camzmac/internet-alarm-clock/BOM.xlsx

Project | Alarm Clock | Number of boards: | 1
Revision | A1
Date | 2017-02-08
By | Cameron MacGregor
ID | SCHEMATIC REFS | DESCRIPTION | MFG | MFG PART # | Digi-Key PART # | UNIT PRICE [CAD] | QUANTITY PER BOARD | ORDER QUANTITY | SUBTOTAL | COMMENT
 | n/a | LAUNCHPAD DEV BRD FOR MSP430G2XX | Texas Instruments | MSP-EXP430G2 | 296-27570-ND | 15.21 | 0 | 0 | 0 | Backup MCU platform
 | n/a | LED 7-SEG .4" 4DGT COMMON CATHODE | Lite-On Inc. | LTC-4727JR | 160-1551-5-ND | 5.81 | 0 | 0 | 0 | Replaced with HDSP-B03E
 | U1 | IC DVR LED 64LED/7SEG I2C 24QSOP | ams | AS1115-BSST | AS1115-BSSTCT-ND | 6.31 | 1 | 2 | 12.62
 | DS2 | LCD DISPLAY RGB LED BKLT 20 X 2 | Newhaven Display Intl | NHD-C0220BIZ-FS(RGB)-FBW-3VM | NHD-C0220BIZ-FS(RGB)-FBW-3VM-ND | 17.6 | 1 | 1 | 17.6
 | n/a | CONN HEADER VERT 6POS .100 TIN | TE Connectivity AMP Connectors | 640456-6 | A1923-ND | 0.4 | 0 | 0 | 0 | Replaced with 61200621621
 | n/a | CONN RECEPT 6POS 24AWG MTA100 | TE Connectivity AMP Connectors | 3-640441-6 | A30982-ND | 0.65 | 0 | 0 | 0 | Replaced with 71600-006LF
 | C1, C2, C4 | CAP CER 1UF 25V X7R 1206 | Yageo | CC1206KKX7R8BB105 | 311-1356-1-ND | 0.25 | 3 | 6 | 1.5
 | n/a | DIODE GEN PURP 100V 200MA DO35 | Fairchild/ON Semiconductor | N4148 | 1N4148FS-ND | 0.15 | 0 | 0 | 0 | Replaced with MMBD914LT1G
 | R1 | RES SMD 27.4K OHM 1% 1/4W 1206 | Panasonic Electronic Components | ERJ-8ENF2742V | P27.4KFCT-ND | 0.15 | 1 | 2 | 0.3
 | R2, R3, R4, R15 | RES SMD 10K OHM 5% 1/4W 1206 | Yageo | RC1206JR-0710KL | 311-10KERCT-ND | 0.16 | 4 | 8 | 1.28
 | DS1 | DISPLAY 7SEG 4DIG HER CC 0.56" COMMON CATHODE | Broadcom Limited | HDSP-B03E | 516-2745-ND | 4.68 | 1 | 1 | 4.68
 | C3 | CAP 10UF 10% 16V 1206 X5R | Taiyo Yuden | EMK316BJ106KD-T | 587-4857-1-ND | 0.37 | 1 | 2 | 0.74
 | SW5, SW6, SW7 | SWITCH TACTILE SPST-NO 0.05A 24V | Omron Electronics Inc-EMC Div | B3F-3152 | SW410-ND | 0.84 | 3 | 4 | 3.36
 | n/a | CAP TACTILE SQUARE LIGHT GREEN | Omron Electronics Inc-EMC Div | B32-1070 | SW953-ND | 0.45 | 1 | 1 | 0.45 | Cap for SW5
 | n/a | CAP TACTILE SQUARE RED | Omron Electronics Inc-EMC Div | B32-1080 | SW252-ND | 0.45 | 1 | 1 | 0.45 | Cap for SW6
 | n/a | CAP TACTILE SQUARE BLUE | Omron Electronics Inc-EMC Div | B32-1040 | SW250-ND | 0.45 | 1 | 1 | 0.45 | Cap for SW7
 | SW1, SW2, SW3, SW4 | SWITCH TACTILE SPST-NO 0.05A 12V | E-Switch | TL1105SPF160Q | EG1861-ND | 0.39 | 4 | 5 | 1.95
 | n/a | CAP PUSHBUTTON ROUND WHITE | E-Switch | 1RWHT | EG1881-ND | 0.27 | 4 | 4 | 1.08 | Cap for SW1, SW2, SW3, SW4
 | D1, D2, D3, D4 | DIODE GEN PURP 100V 200MA SOT23 | ON Semiconductor | MMBD914LT1G | MMBD914LT1GOSCT-ND | 0.16 | 4 | 8 | 1.28
 | Q1, Q2, Q3 | TRANS NPN 40V 0.2A SOT23 | ON Semiconductor | MMBT3904LT1G | MMBT3904LT1GOSCT-ND | 0.15 | 3 | 6 | 0.9
 | R5, R6, R7, R8, R9, R11, R13 | RES SMD 130 OHM 5% 1/4W 1206 | Yageo | RC1206JR-07130RL | 311-130ERCT-ND | 0.16 | 7 | 14 | 2.24
 | R10 | RES SMD 287 OHM 1% 1/4W 1206 | Panasonic Electronic Components | ERJ-8ENF2870V | P287FCT-ND | 0.16 | 1 | 2 | 0.32
 | R12 | RES SMD 165 OHM 1% 1/4W 1206 | Yageo | RC1206FR-07165RL | 311-165FRCT-ND | 0.16 | 1 | 2 | 0.32
 | R14 | RES SMD 200 OHM 1% 1/4W 1206 | Yageo | RC1206FR-07200RL | 311-200FRCT-ND | 0.16 | 1 | 2 | 0.32
 | P1 | CONN HEADER 6POS DUAL VERT PCB | Amphenol FCI | 75869-131LF | 609-2845-ND | 1.04 | 1 | 1 | 1.04
 | n/a | CONN SOCKET IDC 6POS DL SR 30AU | Amphenol FCI | 71600-006LF | 609-2841-ND | 1.25 | 2 | 2 | 2.5 | Mating connector for 75869-131LF
 | n/a | CBL RIBN 6COND 0.050 GRAY 5' | 3M | 3365/06 300SF | MC06G-5-ND | 4.59 | 1 | 1 | 4.59 | Wire for 71600-006LF
 | n/a | BRD SPT SNAP LOCK SCREW MNT 3/4" | Essentra Components | SRS4-12-01 | RPC1432-ND | 0.66 | 0 | 0 | 0 | Replaced with DLMSPM-8-01
 | DS2 | MACHINE SCREW PAN PHILLIPS 2-56 | B&F Fastener Supply | PMSSS 256 0025 PH | H700-ND | 0.121 | 4 | 4 | 0.484 | Mounting screws for DS2
 | DS2 | HEX NUT 3/16" STN STEEL 2-56 | B&F Fastener Supply | HNSS256 | H723-ND | 0.088 | 4 | 4 | 0.352 | Mounting washers for DS2
 | n/a | IDC BREAKOUT HELPER 2 x 3 CONDUCTOR | Adafruit Industries LLC | 2105 | 1528-1499-ND | 1.35 | 1 | 1 | 1.35 | Interfaces IDC connector to breadboard (prototype only)
 | n/a | MODULE BREAK OUT ESP8266 802.11 | Adafruit Industries LLC | 2471 | 1528-1223-ND | 14.1 | 1 | 1 | 14.1 | Wi-Fi and MCU module for breadboard
 | n/a | CONN PWR JACK 2X5.5MM SOLDER | CUI Inc. | PJ-102AH | CP-102AH-ND | 1.08 | 1 | 1 | 1.08 | DC barrel jack for breadboard
 | n/a | AC/DC WALL MOUNT ADAPTER 5V 5W | XP Power | VEL05US050-US-JA | 1470-2771-ND | 10.47 | 1 | 1 | 10.47 | Power supply for breadboard
 | n/a | MOD USB UART MINI B DEV FT232R | FTDI, Future Technology Devices International Ltd | UB232R | 768-1022-ND | 24.8 | 1 | 1 | 24.8 | To connect ESP8266 module to PC for programming
 | Screw holes at edge of pcb | BRD SPT SNAP LOCK NYLON 1/2" | Essentra Components | DLMSPM-8-01 | DLMSPM-8-01-ND | 0.51 | 0 | 0 | 0 | Replaced with DLMSPM-14-01
 | Screw holes at edge of pcb | BRD SPT SNAP LOCK NYLON 7/8" | Essentra Components | DLMSPM-14-01 | RPC1316-ND | 0.61 | 4 | 4 | 2.44
