camzmac/internet-alarm-clock/frontpanel/alarm_clock_front_panel.kicad_pcb

## KiCad design frontpanel/alarm_clock_front_panel.kicad_pcb (2018-04-07)

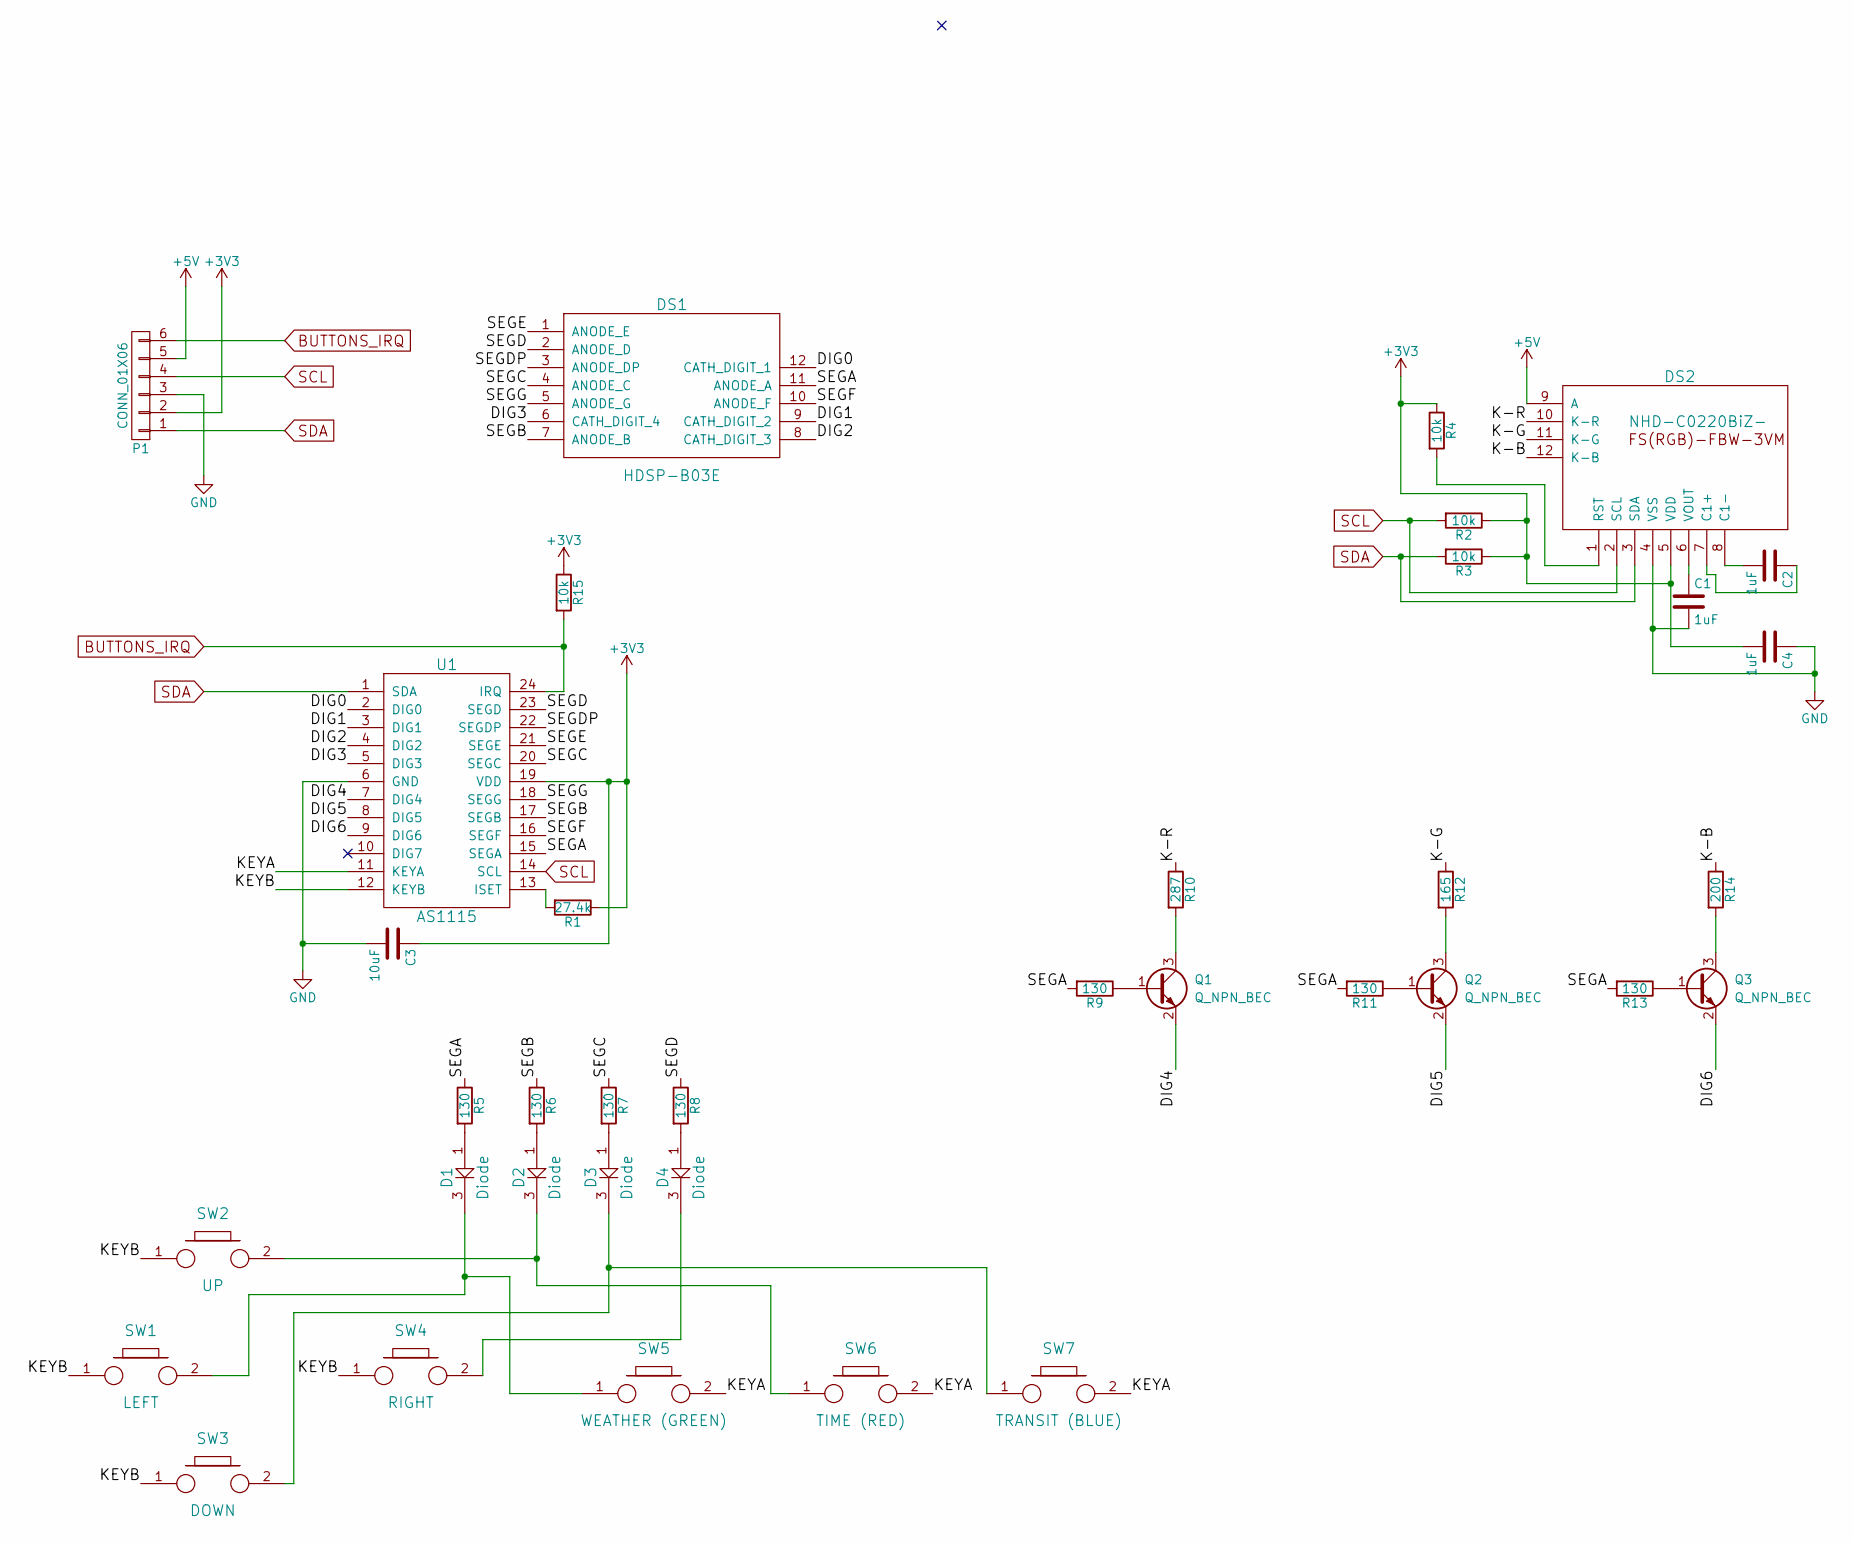
[picture p1: schematic alarm_clock_front_panel.sch, Alarm Clock Front Panel]

Parts:
C1, C2, C4: 1uF; C_1206_HandSoldering
C3: 10uF; C_1206_HandSoldering
D1, D2, D3, D4: Diode; SOT-23_Handsoldering
DS1: HDSP-B03E
DS2: NHD-C0220BiZ-; NHD-C0220BIZ-FS(RGB)-FBW-3VM
P1: CONN_01X06; IDC_Header_Straight_6pins
Q1, Q2, Q3: Q_NPN_BEC; SOT-23_Handsoldering
R1: 27.4k; R_1206_HandSoldering; Tolerance 1%
R2, R3, R4, R15: 10k; R_1206_HandSoldering
R5, R6, R7, R8, R9, R11, R13: 130; R_1206_HandSoldering
R10: 287; R_1206_HandSoldering
R12: 165; R_1206_HandSoldering
R14: 200; R_1206_HandSoldering
SW1: LEFT; TL1105SPF160Q
SW2: UP; TL1105SPF160Q
SW3: DOWN; TL1105SPF160Q
SW4: RIGHT; TL1105SPF160Q
SW5: WEATHER (GREEN); SW_Tactile_SPST_Angled
SW6: TIME (RED); SW_Tactile_SPST_Angled
SW7: TRANSIT (BLUE); SW_Tactile_SPST_Angled
U1: AS1115; SSOP-24_3.9x8.7mm_Pitch0.635mm

Connections:
+3V3: C3.1, C4.2, DS2.5 (VDD), P1.2, R1.1, R2.1, R3.1, R4.1, R15.1, U1.19 (VDD)
+5V: DS2.9 (A), P1.5
/DIG0: DS1.12 (CATH_DIGIT_1), U1.2 (DIG0)
/DIG1: DS1.9 (CATH_DIGIT_2), U1.3 (DIG1)
/DIG2: DS1.8 (CATH_DIGIT_3), U1.4 (DIG2)
/DIG3: DS1.6 (CATH_DIGIT_4), U1.5 (DIG3)
/DIG4: Q1.2 (E), U1.7 (DIG4)
/DIG5: Q2.2 (E), U1.8 (DIG5)
/DIG6: Q3.2 (E), U1.9 (DIG6)
/K-B: DS2.12 (K-B), R14.1
/K-G: DS2.11 (K-G), R12.1
/K-R: DS2.10 (K-R), R10.1
/KEYA: SW5.2, SW6.2, SW7.2, U1.11 (KEYA)
/KEYB: SW1.1, SW2.1, SW3.1, SW4.1, U1.12 (KEYB)
/SEGA: DS1.11 (ANODE_A), R5.1, R9.2, R11.2, R13.2, U1.15 (SEGA)
/SEGB: DS1.7 (ANODE_B), R6.1, U1.17 (SEGB)
/SEGC: DS1.4 (ANODE_C), R7.1, U1.20 (SEGC)
/SEGD: DS1.2 (ANODE_D), R8.1, U1.23 (SEGD)
/SEGDP: DS1.3 (ANODE_DP), U1.22 (SEGDP)
/SEGE: DS1.1 (ANODE_E), U1.21 (SEGE)
/SEGF: DS1.10 (ANODE_F), U1.16 (SEGF)
/SEGG: DS1.5 (ANODE_G), U1.18 (SEGG)
BUTTONS_IRQ: P1.6, R15.2, U1.24 (IRQ)
GND: C1.2, C3.2, C4.1, DS2.4 (VSS), P1.3, U1.6 (GND)
unnamed: C1.1, DS2.6 (VOUT)
unnamed: C2.1, DS2.7 (C1+)
unnamed: C2.2, DS2.8 (C1-)
unnamed: D1.1, R5.2
unnamed: D1.3, SW1.2, SW5.1
unnamed: D2.1, R6.2
unnamed: D2.3, SW2.2, SW6.1
unnamed: D3.1, R7.2
unnamed: D3.3, SW3.2, SW7.1
unnamed: D4.1, R8.2
unnamed: D4.3, SW4.2
unnamed: DS2.1 (RST), R4.2
unnamed: Q1.1 (B), R9.1
unnamed: Q1.3 (C), R10.2
unnamed: Q2.1 (B), R11.1
unnamed: Q2.3 (C), R12.2
unnamed: Q3.1 (B), R13.1
unnamed: Q3.3 (C), R14.2
unnamed: R1.2, U1.13 (ISET)
SCL: DS2.2 (SCL), P1.4, R2.2, U1.14 (SCL)
SDA: DS2.3 (SDA), P1.1, R3.2, U1.1 (SDA)

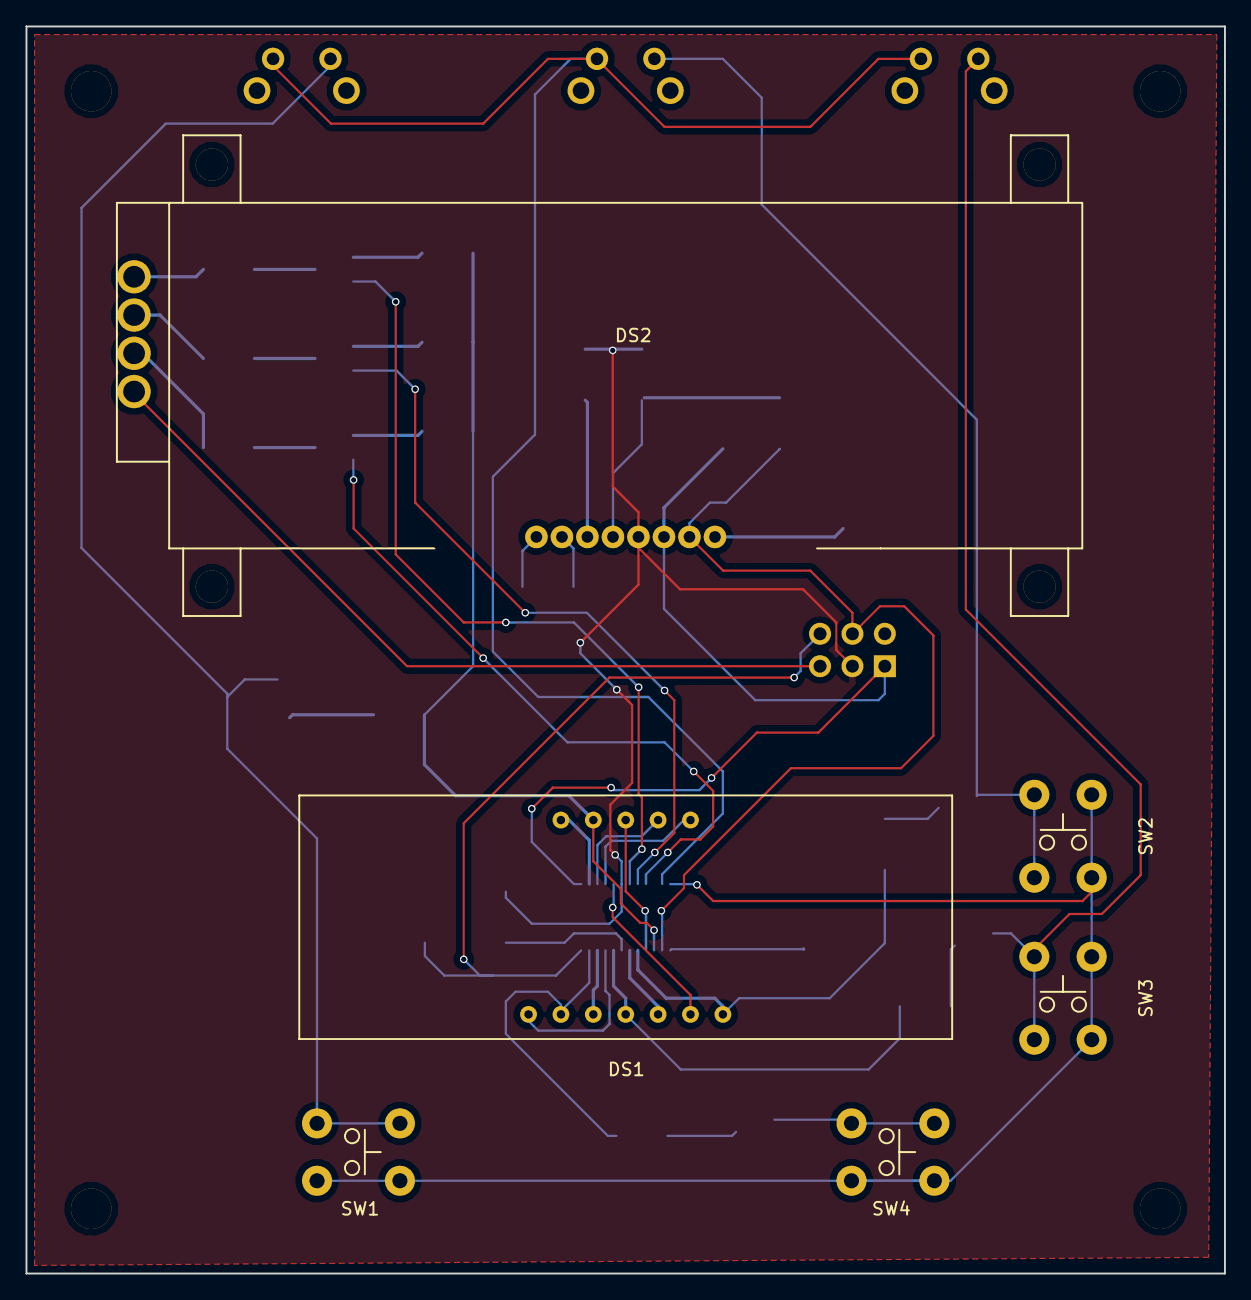
[picture p2: board alarm_clock_front_panel.kicad_pcb from above]

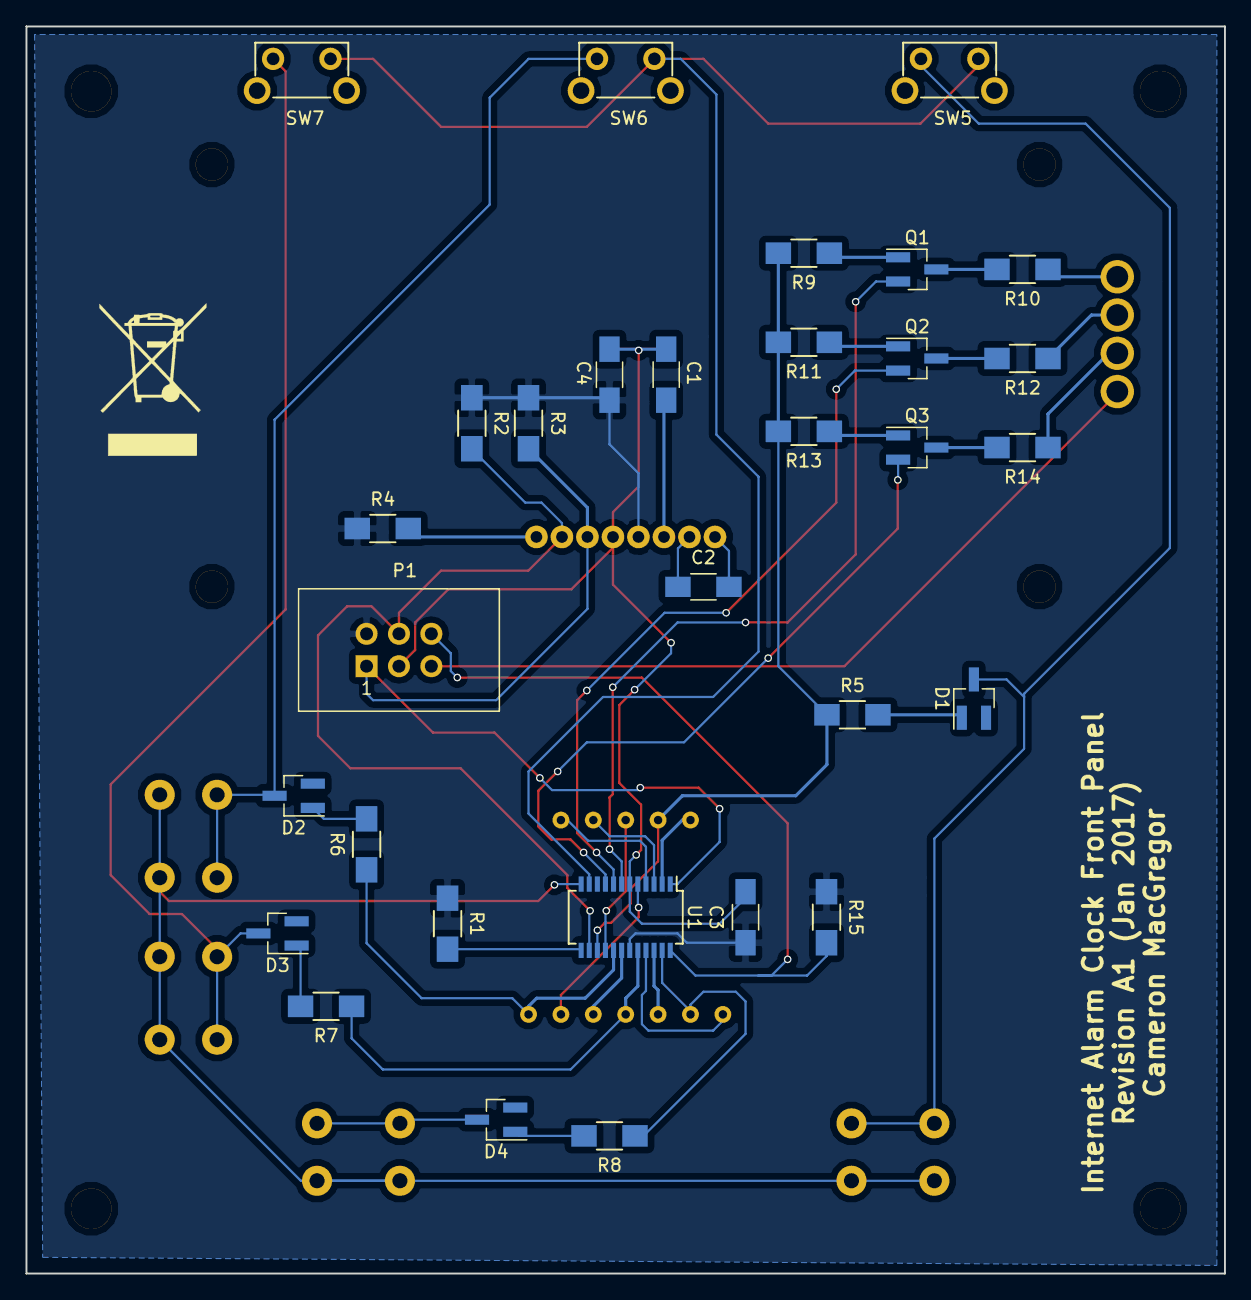
[picture p3: board alarm_clock_front_panel.kicad_pcb from below]

Board: 2 copper layers, 94.0 x 97.8 mm, 37 parts (31 on the bottom side), 45 nets.
