camzmac/internet-alarm-clock/(commit log)

2018-04-07 Started version control on Internet Alarm Clock project. Designed front panel user interface PCB with I2C bus and implemented basic alarm clock functionality in Lua with NodeMCU firmware on ESP8266.
    [BOM.xlsx, alarm_clock_front_panel.kicad_pcb, alarm_clock_front_panel.sch]
2018-05-04 Added TI USCI I2C library, sample code for MSP430 (ESP8266 <-> MSP430 <-> front panel)
